tudsat-rocket/tank_level_indicator_board/sensor_58cm/tank_level_indicator_sensor_58cm.step

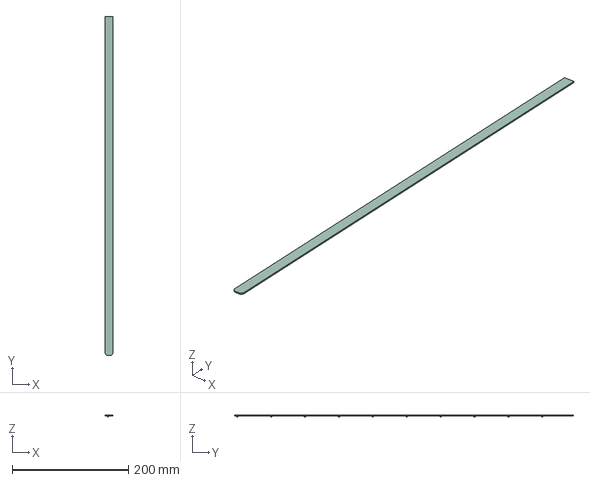
[picture p1: CAD file, 2026-07-10]
sensor_58cm/tank_level_indicator_sensor_58cm.step
13.0 x 583.2 x 2.79 mm
SOT-23 x 10
tank_level_indicator_sensor_PCB
