tudsat-rocket/tank_level_indicator_board/transport_case/tank_level_indicator_case_top.step

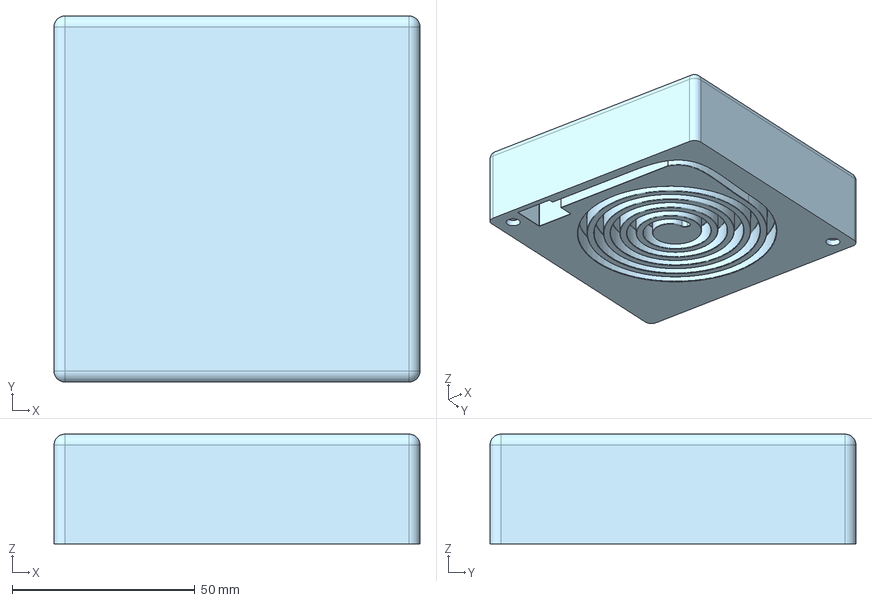
[picture p2: CAD file, 2026-07-10]
transport_case/tank_level_indicator_case_top.step
100.0 x 100.0 x 30.0 mm
