tudsat-rocket/tank_level_indicator_board/board/3D-Models/66200821022 (rev1).stp

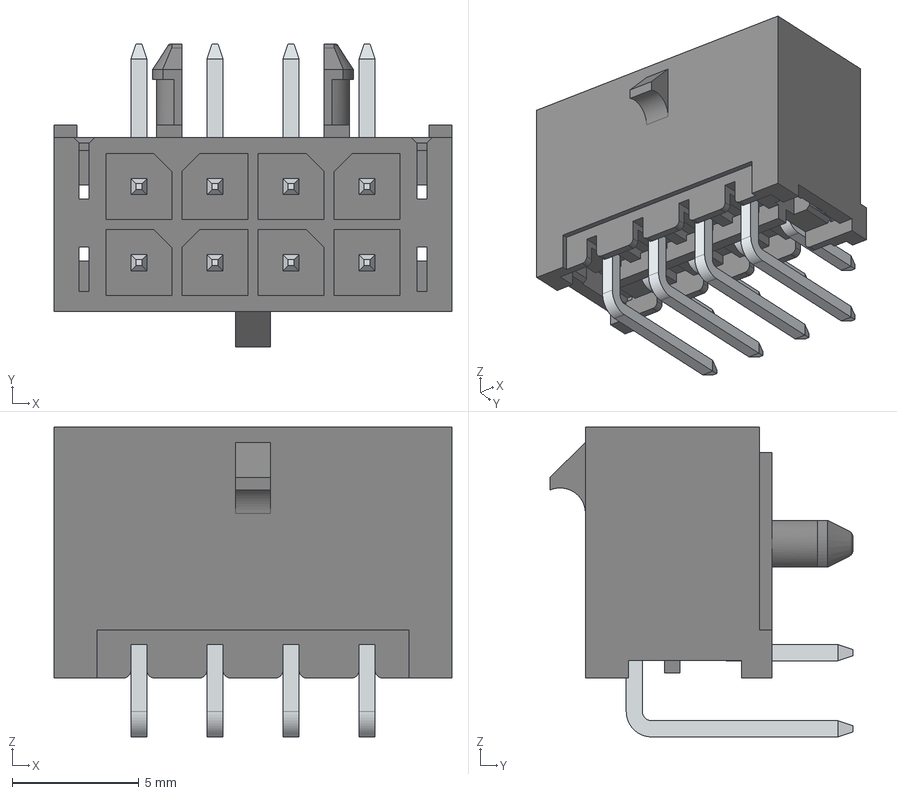
[picture p4: CAD file, 2026-07-10]
board/3D-Models/66200821022 (rev1).stp
15.7 x 12.0 x 12.2 mm
6620xx21022_PIN_COURTE x 4
6620xx21022_PIN_LONGUE x 4
