tudsat-rocket/tank_level_indicator_board/(list of files, cad)

Other CAD files:
sensor_58cm/tank_level_indicator_sensor_58cm.stl
