tudsat-rocket/tank_level_indicator_board/board/tank_level_indicator_board.pdf

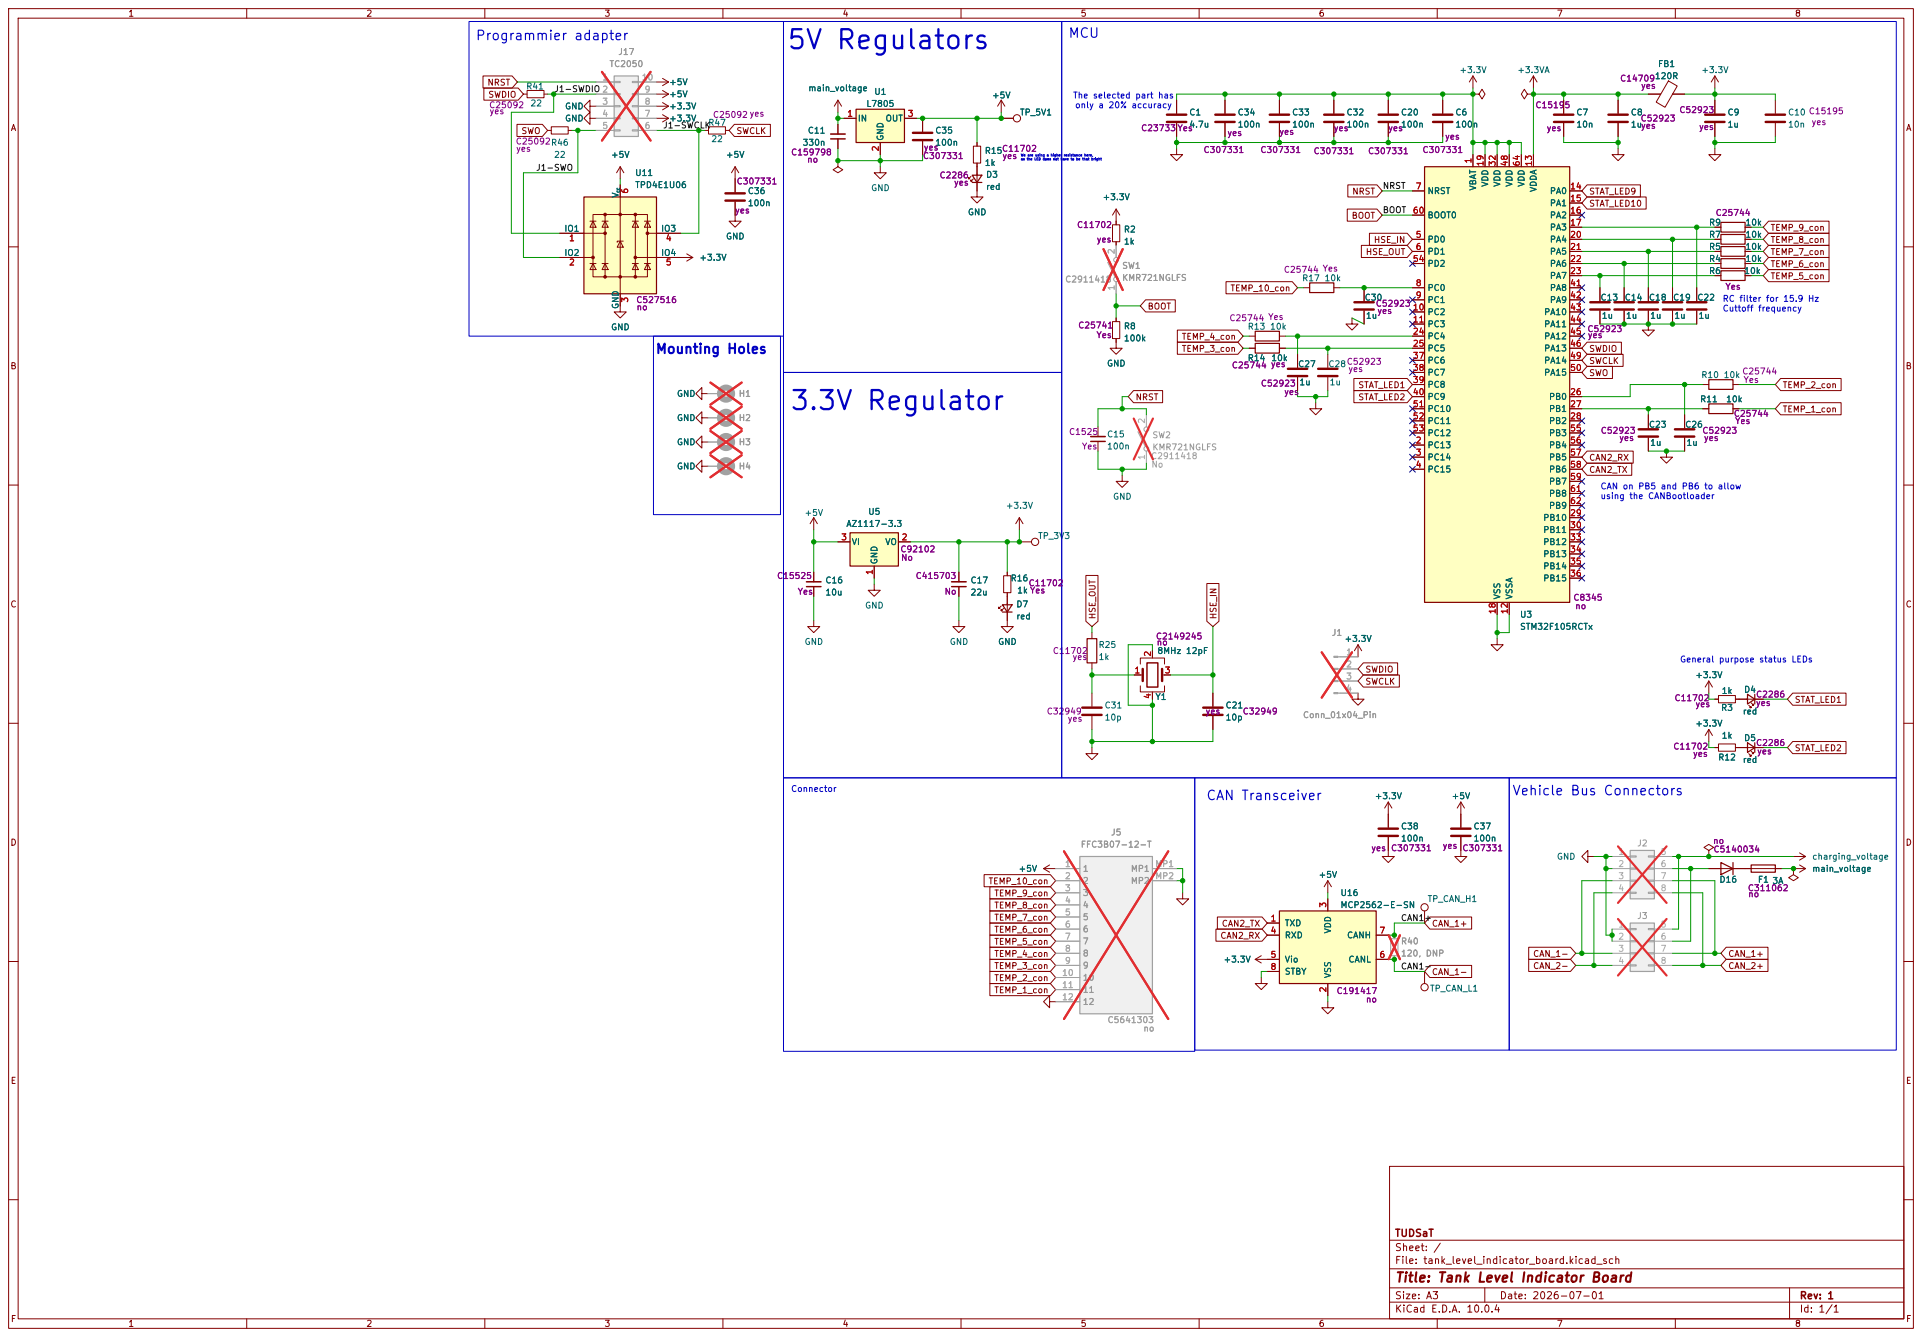
[picture p5: page 1]

CAN on PB5 and PB6 to allow

using the CANBootloader General purpose status LEDs CAN Transceiver

TUDSaT
Sheet: /
File: tank_level_indicator_board.kicad_sch
Title: Tank Level Indicator Board

Size: A3 | Rev: 1
KiCad E.D.A. 10.0.4 | Id: 1/1
