tudsat-rocket/tank_level_indicator_board/sensor_58cm/tank_level_indicator_sensor_58cm.pdf

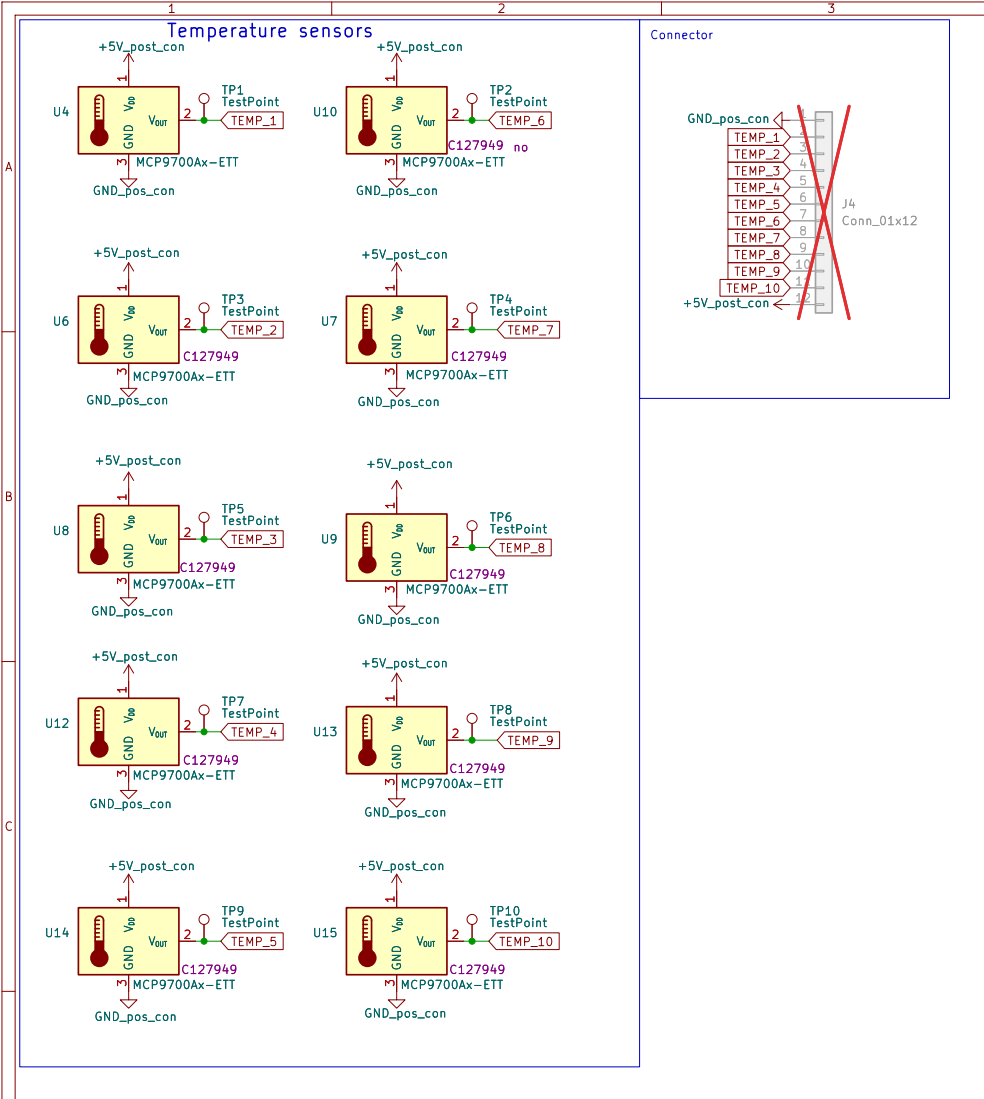
[picture p6: page 1]

TUDSaT
Sheet: /
File: tank_level_indicator_sensor_58cm.kicad_sch
Title: Tank level Indicator sensor

Size: A3 | Rev: 1
KiCad E.D.A. 10.0.4 | Id: 1/1
