tudsat-rocket/tank_level_indicator_board/board/tank_level_indicator_board.kicad_pcb

## KiCad design board/tank_level_indicator_board.kicad_pcb (2026-07-10)

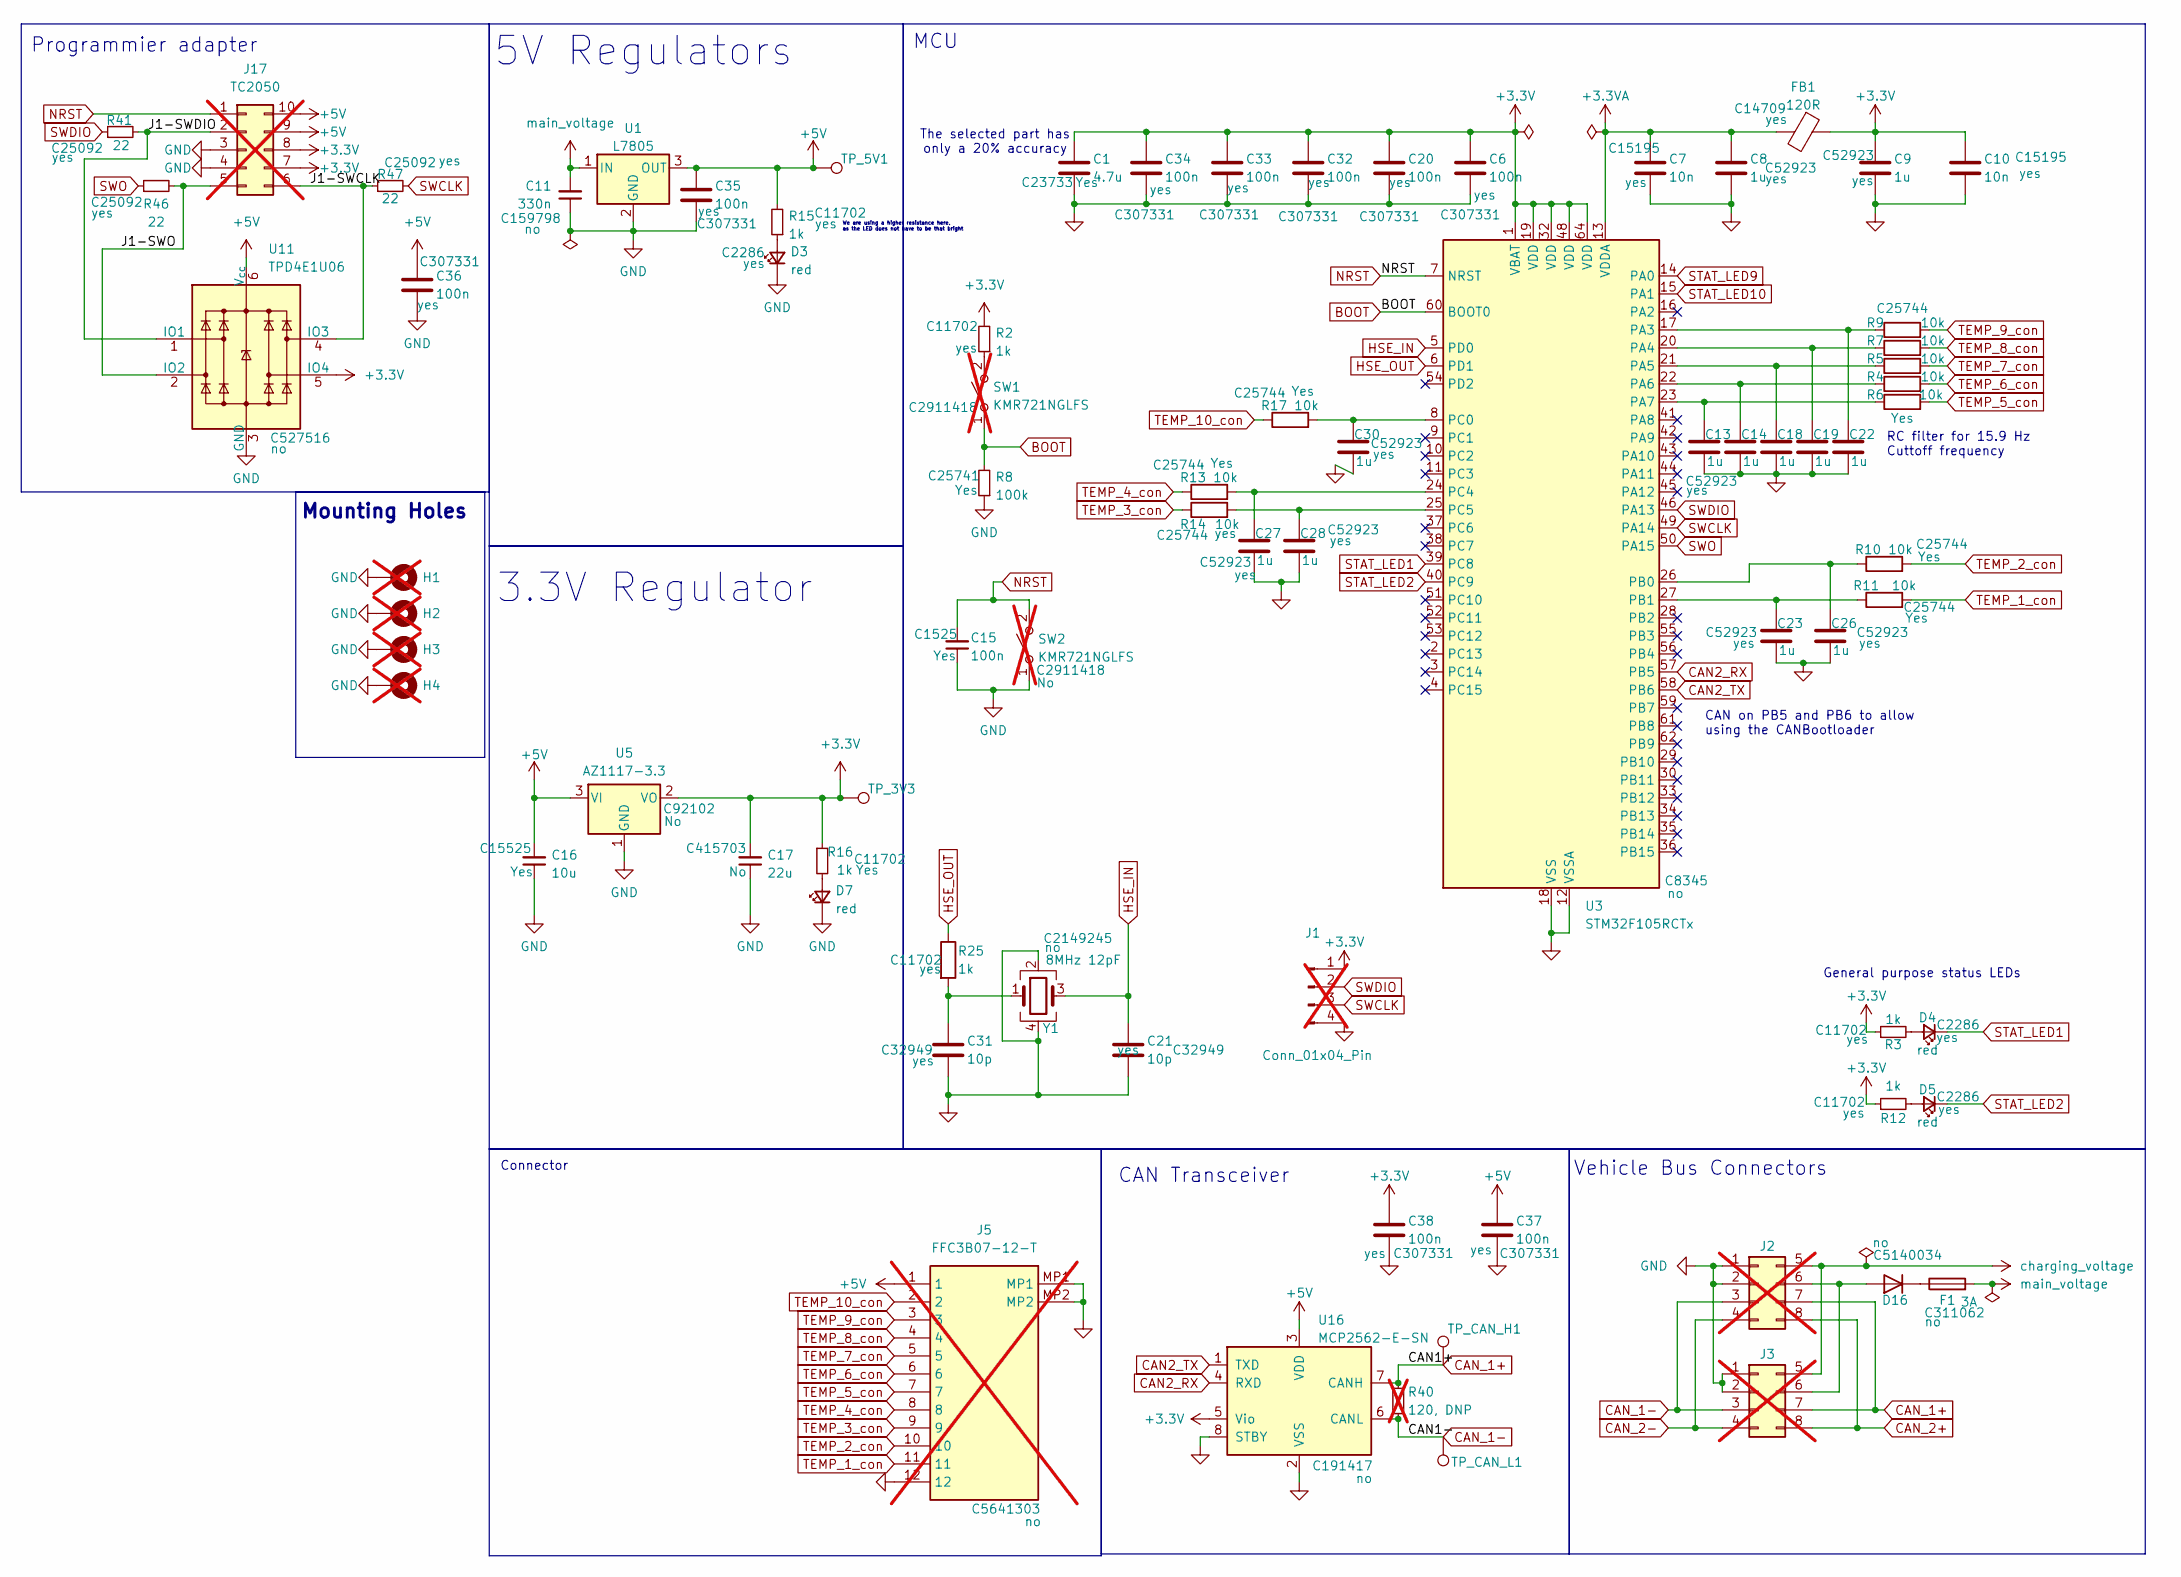
[picture p7: schematic tank_level_indicator_board.kicad_sch, Tank Level Indicator Board]

Parts:
C1: 4.7u; C_0402_1005Metric; LCSC C23733
C6, C20, C32, C33, C34, C35, C36, C37, C38: 100n; C_0402_1005Metric; LCSC C307331
C7, C10: 10n; C_0402_1005Metric; LCSC C15195
C8, C9, C13, C14, C18, C19, C22, C23, C26, C27, C28, C30: 1u; C_0402_1005Metric; LCSC C52923
C11: 330n; C_0603_1608Metric; Part# CL10B334KO8NNNC; LCSC C159798
C15: 100n; C_0402_1005Metric; Part# CL10B104KB8NNNC; LCSC C1525
C16: 10u; C_0402_1005Metric; LCSC C15525
C17: 22u; C_0402_1005Metric; Part# GRM155R60J226ME11D; LCSC C415703
C21, C31: 10p; C_0402_1005Metric; LCSC C32949
D3, D4, D5: red; LED_0603_1608Metric; LCSC C2286
D7: red; LED_0603_1608Metric; Part# 19-213/RSC-BS2T2B/3T; LCSC# C474026
D16: D; D_SMA; LCSC C5140034
F1: 3A; Fuse_0603_1608Metric_Pad1.05x0.95mm_HandSolder; LCSC C311062
FB1: 120R; L_0603_1608Metric; Part# BLM18PG121SN1D; LCSC C14709
H1, H2, H3, H4: MountingHole_Pad; MountingHole_3.2mm_M3_Pad_Via; Part# N/A; DigiKey# N/A; not fitted
J1: Conn_01x04_Pin; PinHeader_1x04_P1.27mm_Vertical_SMD_Pin1Left; not fitted
J2, J3: Conn_02x04_Top_Bottom; Molex_Micro-Fit_3.0_43045-0800_2x04_P3.00mm_Horizontal; not fitted
J5: FFC3B07-12-T; FFC3B0712T; Mouser Part Number 640-FFC3B07-12-T; not fitted
J17: TC2050; Tag-Connect_TC2050-IDC-FP_2x05_P1.27mm_Vertical; LCSC# x; not fitted
R2, R15: 1k; R_0402_1005Metric; Part# RC0603FR-0710KL; LCSC C11702
R3, R12, R16, R25: 1k; R_0402_1005Metric; LCSC C11702
R4, R5, R6, R7, R9, R10, R11, R13, R14, R17: 10k; R_0402_1005Metric; LCSC C25744
R8: 100k; R_0402_1005Metric; Part# RC0603FR-0710KL; LCSC C25741
R40: 120, DNP; R_0603_1608Metric_Pad0.98x0.95mm_HandSolder; LCSC x; not fitted
R41, R46, R47: 22; R_0402_1005Metric; Part# RC0603FR-0710KL; LCSC C25092
SW1, SW2: KMR721NGLFS; SW_Push_1P1T_NO_CK_KMR2; Part# KMR721NGLFS; LCSC C2911418; not fitted
TP_3V3: 3V3; TestPoint_Pad_D1.5mm
TP_5V1: 5V; TestPoint_Pad_D1.5mm
TP_CAN_H1: CAN_H; TestPoint_Pad_D1.5mm
TP_CAN_L1: CAN_L; TestPoint_Pad_D1.5mm
U1: L7805; TO-252-2; Part# L7805CDT-TR; LCSC# C310413
U3: STM32F105RCTx; LQFP-64_10x10mm_P0.5mm; LCSC C8345
U5: AZ1117-3.3; SOT-223-3_TabPin2; LCSC C92102
U11: TPD4E1U06; SOT-563; LCSC C527516
U16: MCP2562-E-SN; SOIC-8_3.9x4.9mm_P1.27mm; Part# MCP2562T-E/SN; LCSC C191417
Y1: 8MHz 12pF; Crystal_SMD_5032-4Pin_5.0x3.2mm; Part# 5TJ480000NYLBC; LCSC C2149245

Connections:
+3.3V: C1.1, C6.1, C9.1, C10.1, C17.2, C20.1, C32.1, C33.1, C34.1, C38.1, FB1.1, J1.1, J17.7, J17.8, R2.2, R3.1, R12.1, R16.1, TP_3V3.1 (1_1), U3.1 (VBAT), U3.19 (VDD), U3.32 (VDD), U3.48 (VDD), U3.64 (VDD), U5.2 (VO), U11.5 (IO4), U16.5 (Vio)
+3.3VA: C7.1, C8.1, FB1.2, U3.13 (VDDA)
+5V: C16.2, C35.1, C36.1, C37.1, J5.1, J17.9, J17.10, R15.2, TP_5V1.1 (1_1), U1.3 (OUT), U5.3 (VI), U11.6 (V_{cc}), U16.3 (VDD)
/J1-SWCLK: J17.6, R47.1, U11.4 (IO3)
/J1-SWDIO: J17.2, R41.2, U11.1 (IO1)
/J1-SWO: J17.5, R46.2, U11.2 (IO2)
BOOT: R8.2, SW1.1 (A), U3.60 (BOOT0)
CAN2_RX: U3.57 (PB5), U16.4 (RXD)
CAN2_TX: U3.58 (PB6), U16.1 (TXD)
CAN_1+: J2.7, J3.7, R40.1, TP_CAN_H1.1 (1_1), U16.7 (CANH)
CAN_1-: J2.3, J3.3, R40.2, TP_CAN_L1.1 (1_1), U16.6 (CANL)
CAN_2+: J2.8, J3.8
CAN_2-: J2.4, J3.4
GND: C1.2, C6.2, C7.2, C8.2, C9.2, C10.2, C11.1, C13.2, C14.2, C15.1, C16.1, C17.1, C18.2, C19.2, C20.2, C21.2, C22.2, C23.2, C26.2, C27.2, C28.2, C30.2, C31.2, C32.2, C33.2, C34.2, C35.2, C36.2, C37.2, C38.2, D3.1 (K), D7.1 (K), H1.1 (1_1), H2.1 (1_1), H3.1 (1_1), H4.1 (1_1), J1.4, J2.1, J2.2, J3.1, J3.2, J5.12, J5.MP1, J5.MP2, J17.3, J17.4, R8.1, SW2.1 (A), U1.2 (GND), U3.12 (VSSA), U3.18 (VSS), U3.31 (VSS), U3.47 (VSS), U3.63 (VSS), U5.1 (GND), U11.3 (GND), U16.2 (VSS), U16.8 (STBY), Y1.2, Y1.4
HSE_IN: C21.1, U3.5 (PD0), Y1.3
HSE_OUT: R25.1, U3.6 (PD1)
NRST: C15.2, J17.1, SW2.2 (B), U3.7 (NRST)
unnamed: C31.1, R25.2, Y1.1
unnamed: D3.2 (A), R15.1
unnamed: D4.2 (A), R3.2
unnamed: D5.2 (A), R12.2
unnamed: D7.2 (A), R16.2
unnamed: D16.2 (A), J2.6, J3.6
unnamed: D16.1 (K), F1.1
unnamed: R2.1, SW1.2 (B)
unnamed: C22.1, R9.1, U3.17 (PA3)
unnamed: C19.1, R7.1, U3.20 (PA4)
unnamed: C18.1, R5.1, U3.21 (PA5)
unnamed: C14.1, R4.1, U3.22 (PA6)
unnamed: C13.1, R6.1, U3.23 (PA7)
unnamed: C26.1, R10.1, U3.26 (PB0)
unnamed: C23.1, R11.1, U3.27 (PB1)
unnamed: C30.1, R17.2, U3.8 (PC0)
unnamed: C27.1, R13.2, U3.24 (PC4)
unnamed: C28.1, R14.2, U3.25 (PC5)
STAT_LED1: D4.1 (K), U3.39 (PC8)
STAT_LED2: D5.1 (K), U3.40 (PC9)
STAT_LED9: U3.14 (PA0)
STAT_LED10: U3.15 (PA1)
SWCLK: J1.3, R47.2, U3.49 (PA14)
SWDIO: J1.2, R41.1, U3.46 (PA13)
SWO: R46.1, U3.50 (PA15)
TEMP_1_con: J5.11, R11.2
TEMP_2_con: J5.10, R10.2
TEMP_3_con: J5.9, R14.1
TEMP_4_con: J5.8, R13.1
TEMP_5_con: J5.7, R6.2
TEMP_6_con: J5.6, R4.2
TEMP_7_con: J5.5, R5.2
TEMP_8_con: J5.4, R7.2
TEMP_9_con: J5.3, R9.2
TEMP_10_con: J5.2, R17.1
charging_voltage: J2.5, J3.5
main_voltage: C11.2, F1.2, U1.1 (IN)

Notes on the sheet:
We are using a higher resistance here, as the LED does not have to be that bright
Connector
CAN Transceiver
Mounting Holes
5V Regulators
MCU
RC filter for 15.9 Hz Cuttoff frequency
3.3V Regulator
Programmier adapter
CAN on PB5 and PB6 to allow using the CANBootloader
The selected part has only a 20% accuracy
General purpose status LEDs
Vehicle Bus Connectors

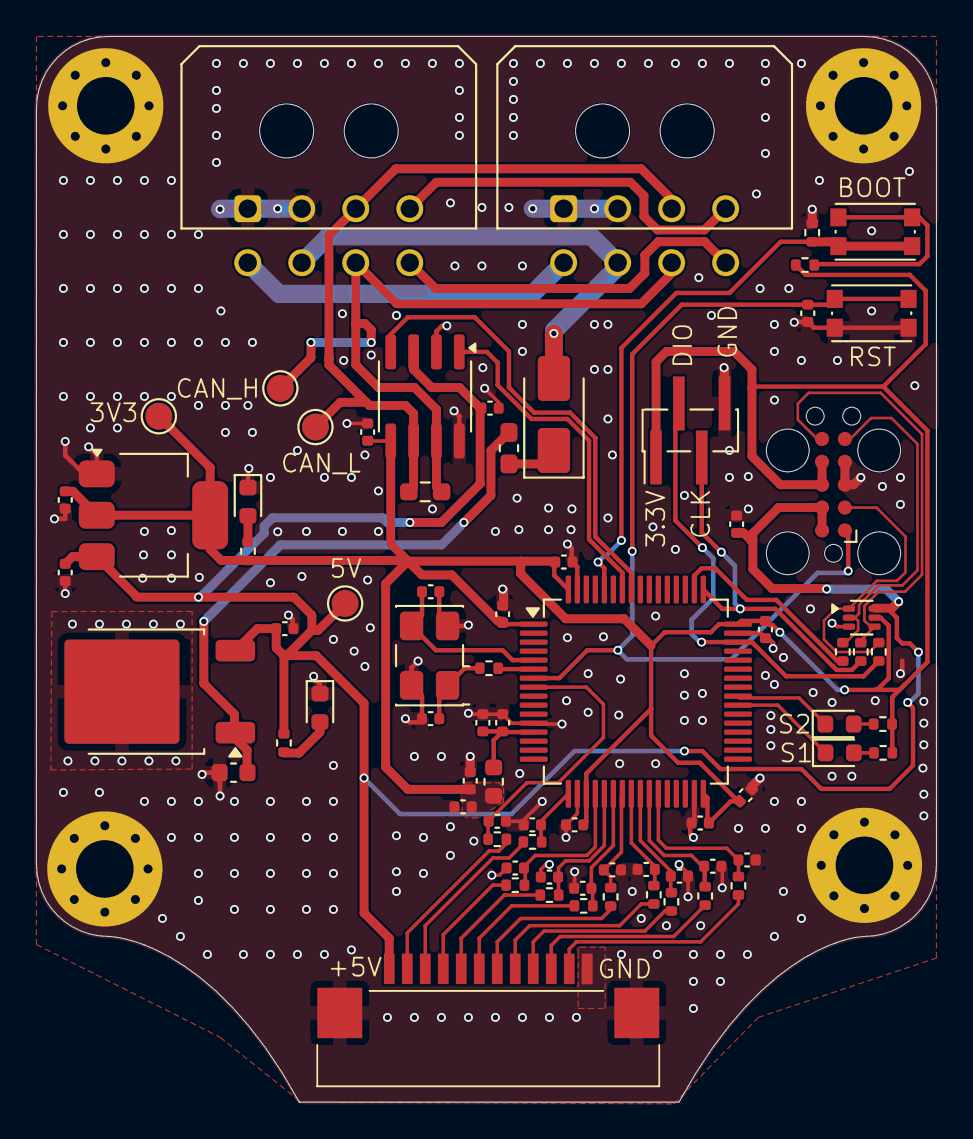
[picture p8: board tank_level_indicator_board.kicad_pcb from above]

Board: 2 copper layers, 50.0 x 59.2 mm, 79 parts (0 on the bottom side), 52 nets.
