tudsat-rocket/tank_level_indicator_board/sensor_58cm/tank_level_indicator_sensor_58cm.kicad_pcb

## KiCad design sensor_58cm/tank_level_indicator_sensor_58cm.kicad_pcb (2026-06-14)

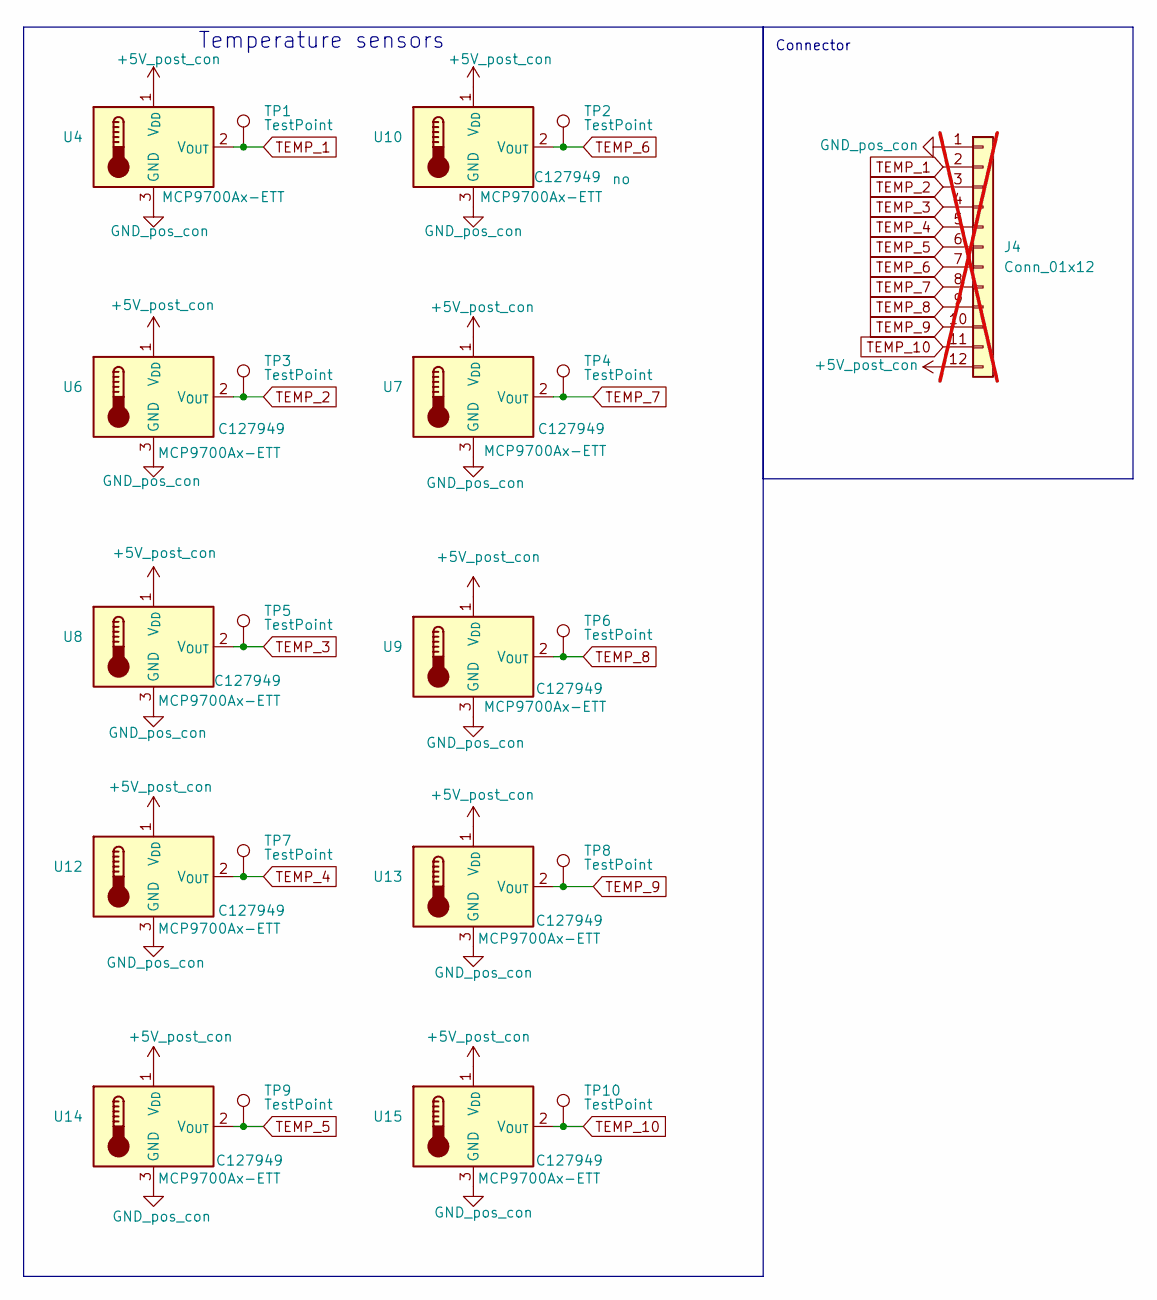
[picture p9: schematic tank_level_indicator_sensor_58cm.kicad_sch, Tank level Indicator sensor]

Parts:
J4: Conn_01x12; FFC3B07_pad; not fitted
TP1, TP2, TP3, TP4, TP5, TP6, TP7, TP8, TP9, TP10: TestPoint; TestPoint_Pad_D1.0mm
U4, U6, U7, U8, U9, U10, U12, U13, U14, U15: MCP9700Ax-ETT; SOT-23; LCSC C127949

Connections:
+5V_post_con: J4.12, U4.1 (V_{DD}), U6.1 (V_{DD}), U7.1 (V_{DD}), U8.1 (V_{DD}), U9.1 (V_{DD}), U10.1 (V_{DD}), U12.1 (V_{DD}), U13.1 (V_{DD}), U14.1 (V_{DD}), U15.1 (V_{DD})
GND_pos_con: J4.1, U4.3 (GND), U6.3 (GND), U7.3 (GND), U8.3 (GND), U9.3 (GND), U10.3 (GND), U12.3 (GND), U13.3 (GND), U14.3 (GND), U15.3 (GND)
TEMP_1: J4.2, TP1.1 (1_1), U4.2 (V_{OUT})
TEMP_2: J4.3, TP3.1 (1_1), U6.2 (V_{OUT})
TEMP_3: J4.4, TP5.1 (1_1), U8.2 (V_{OUT})
TEMP_4: J4.5, TP7.1 (1_1), U12.2 (V_{OUT})
TEMP_5: J4.6, TP9.1 (1_1), U14.2 (V_{OUT})
TEMP_6: J4.7, TP2.1 (1_1), U10.2 (V_{OUT})
TEMP_7: J4.8, TP4.1 (1_1), U7.2 (V_{OUT})
TEMP_8: J4.9, TP6.1 (1_1), U9.2 (V_{OUT})
TEMP_9: J4.10, TP8.1 (1_1), U13.2 (V_{OUT})
TEMP_10: J4.11, TP10.1 (1_1), U15.2 (V_{OUT})

Notes on the sheet:
Connector
Temperature sensors

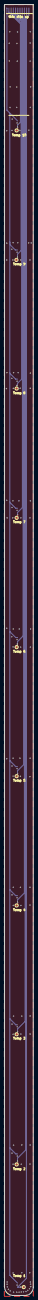
[picture p10: board tank_level_indicator_sensor_58cm.kicad_pcb from above]

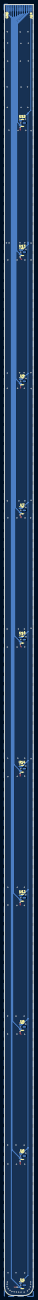
[picture p11: board tank_level_indicator_sensor_58cm.kicad_pcb from below]

Board: 2 copper layers, 13.0 x 583.2 mm, 21 parts (11 on the bottom side), 12 nets.
