tudsat-rocket/tank_level_indicator_board/(commit log)

2025-11-04 finish design
    [rapid_tank_level_indicator.kicad_pcb, rapid_tank_level_indicator.kicad_sch]
2026-05-10 check LCSC parts and small layout adjustments
    [rapid_tank_level_indicator.kicad_pcb, rapid_tank_level_indicator.kicad_sch]
2026-06-03 split board in two projects
    [rapid_tank_level_indicator.kicad_pcb, rapid_tank_level_indicator.kicad_sch, rapid_tank_level_indicator_board.kicad_pcb, rapid_tank_level_indicator_board.kicad_sch, rapid_tank_level_indicator_sensor.kicad_pcb, rapid_tank_level_indicator_sensor.kicad_sch]
2026-06-14 last edits
    [bom.csv, designators.csv, positions.csv, rapid_tank_level_indicator_board.kicad_pcb, rapid_tank_level_indicator_board.kicad_sch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]
2026-07-10 cleanup and export 3d models
    [66200821022 (rev1).stp, bom.csv, designators.csv, positions.csv, rapid_tank_level_indicator_board.kicad_pcb, rapid_tank_level_indicator_board.kicad_sch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]
